ziv50109/smart-litter-cabinet/hardware/xy134-wiring.png

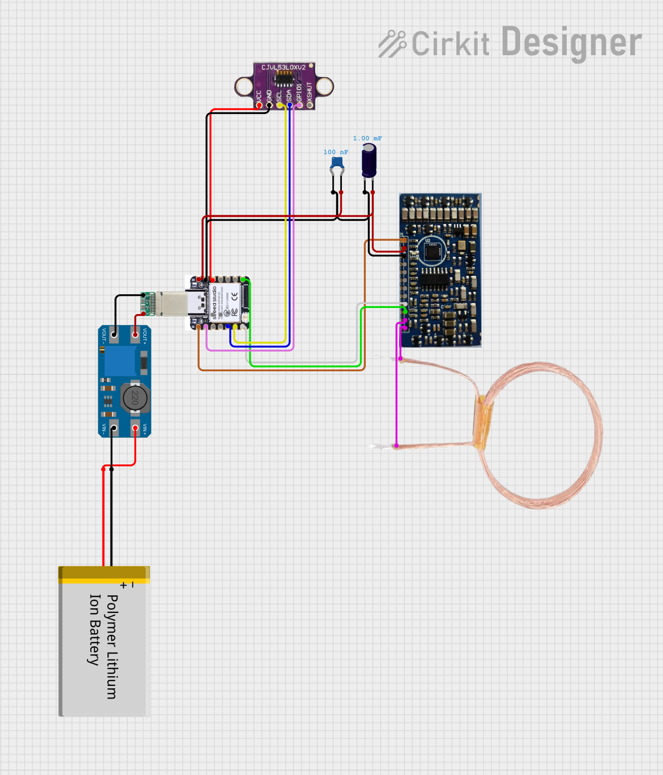
hardware/xy134-wiring.png
