ziv50109/smart-litter-cabinet/firmware/main/certificates.h

#pragma once

#include <Arduino.h>

// Google may serve either RSA (R1) or ECDSA (R4) certificate chains.
// Keep both public trust anchors in one PEM bundle so HTTPS uploads continue
// working when Google rotates the chain used by script.google.com.
static const char GOOGLE_ROOT_CA_BUNDLE[] PROGMEM = R"CERT(
-----BEGIN CERTIFICATE-----
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
bP6MvPJwNQzcmRk13NfIRmPVNnGuV/u3gm3c
-----END CERTIFICATE-----
-----BEGIN CERTIFICATE-----
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
-----END CERTIFICATE-----
)CERT";
