ziv50109/smart-litter-cabinet/experiments/vision/esp32_camera_stream/secrets.example.h

#pragma once

// Copy to secrets.h. Never commit secrets.h.
constexpr char WIFI_SSID[] = "YOUR_WIFI_SSID";
constexpr char WIFI_PASSWORD[] = "YOUR_WIFI_PASSWORD";
constexpr char PC_SERVER_IP[] = "192.168.1.100";
constexpr uint16_t PC_SERVER_PORT = 5000;
