ziv50109/smart-litter-cabinet/firmware/main/smart_litter_monitor/secrets.example.h

#pragma once

// Public, intentionally blank fallback for Cirkit and source control.
// Copy this file to secrets.h ONLY on the local computer used to compile/flash.
#define WIFI_SSID ""
#define WIFI_PASSWORD ""
#define DEVICE_TOKEN ""
#define APP_SCRIPT_URL ""

#define CAT_1_CHIP_HASH 0UL
#define CAT_1_NAME "unknown"
#define CAT_2_CHIP_HASH 0UL
#define CAT_2_NAME "unknown"
