ziv50109/smart-litter-cabinet/(commit log)

2026-09-12 Improve visit detection and RFID identity handling
    Add non-blocking visit state transitions, bounded RFID rescans, timeout-safe closure, persistent interruption handling, and bilingual documentation.
2026-09-12 Require registered RFID before starting visits
    Reject unregistered chips immediately and accumulate only verified clear samples so scheduling jitter cannot force every visit to the 90-second timeout.
    [app_config.h, main.ino, visit_logic.h]
2026-09-12 Separate UART reception from RFID event acceptance
2026-09-15 Add gated RFID battery verification probe
2026-09-16 Add auto probe controller
2026-09-16 Add auto probe secrets example
2026-09-16 Add zero-serial auto probe
2026-09-16 Document zero-serial auto probe
2026-09-16 Add web OTA to auto probe
2026-09-16 Document web OTA flow
2026-09-16 Start auto probe in web maintenance mode
2026-09-16 Simplify auto probe web workflow
2026-09-16 Add low-power production candidate config
2026-09-16 Add short-visit aware visit state machine
    [visit_logic.h]
2026-09-16 Add low-power production candidate firmware
2026-09-16 Promote low-power config to main
2026-09-16 Promote low-power certificates to main
2026-09-16 Promote low-power firmware to main
2026-09-16 Promote low-power secrets template to main
2026-09-16 Promote short-visit state machine to main
    [visit_logic.h]
2026-09-16 Promote low-power README to main
2026-09-16 Harden low-power production config
2026-09-16 Harden production persistence and sensor recovery
2026-09-16 Keep clear samples continuous through RFID timeout
2026-09-16 Document low-power and main host tests
2026-09-17 docs: describe current system behavior
2026-09-17 feat: secure STA management and add connected standby
    [partitions.csv]
2026-09-17 fix: initialize C++ traits before Arduino headers
2026-09-17 fix: configure power limits from SDK CPU frequency
    [power_runtime.h]
2026-09-17 fix: clarify diagnostic append control flow
    [main.ino]
2026-09-17 fix: classify unrecoverable queued timestamps
    [runtime_policy.h]
2026-09-17 fix: quarantine unrecoverable queue heads
    [management_runtime.h]
2026-10-05 fix: insert newest Google Sheet rows first
    * fix: insert newest sheet rows first
    * test: cover newest sheet row ordering
2026-10-23 fix: reduce idle network wakeups and expose power diagnostics
